MrFarbaek/Stensborg-A-S/Epson ET-M1120 modification files v1.1/3D print files/Barrel/ET-M1120 parts/EndLeft.SLDPRT

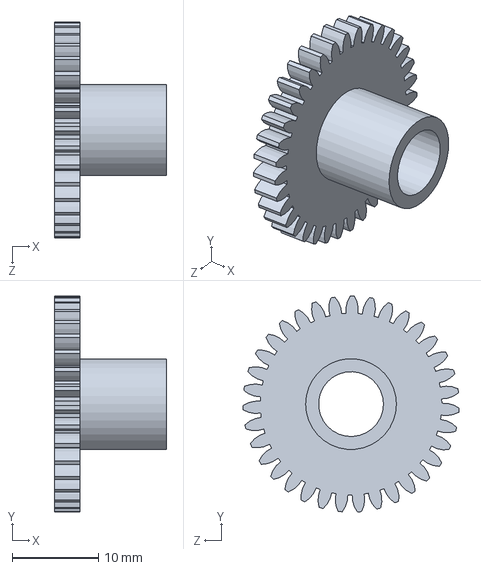
[picture p1: CAD file, 2022-03-11]
Epson ET-M1120 modification files v1.1/3D print files/Barrel/ET-M1120 parts/EndLeft.SLDPRT
13.0 x 25.0 x 25.0 mm
