MrFarbaek/Stensborg-A-S/Epson ET-M1120 modification files v1.1/3D print files/Barrel/SLDPRT files/BracketLeftBarrel.SLDPRT

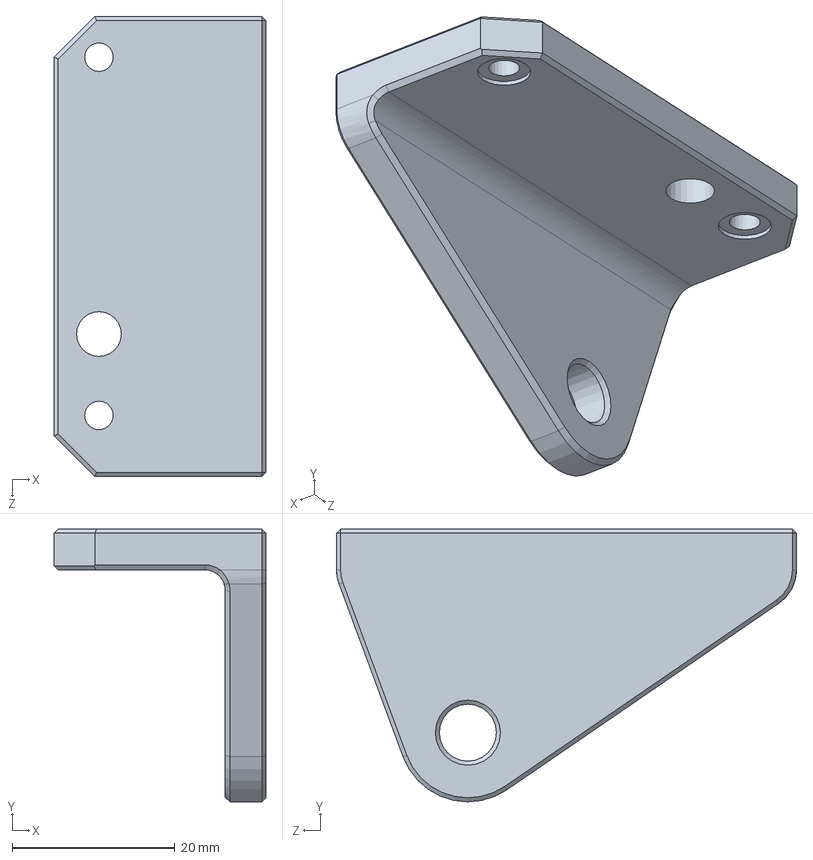
[picture p2: CAD file, 2022-03-11]
Epson ET-M1120 modification files v1.1/3D print files/Barrel/SLDPRT files/BracketLeftBarrel.SLDPRT
26.0 x 33.5 x 56.5 mm
