MrFarbaek/Stensborg-A-S/Epson ET-M1120 modification files v1.1/3D print files/Barrel/STEP files/Barrel.STEP

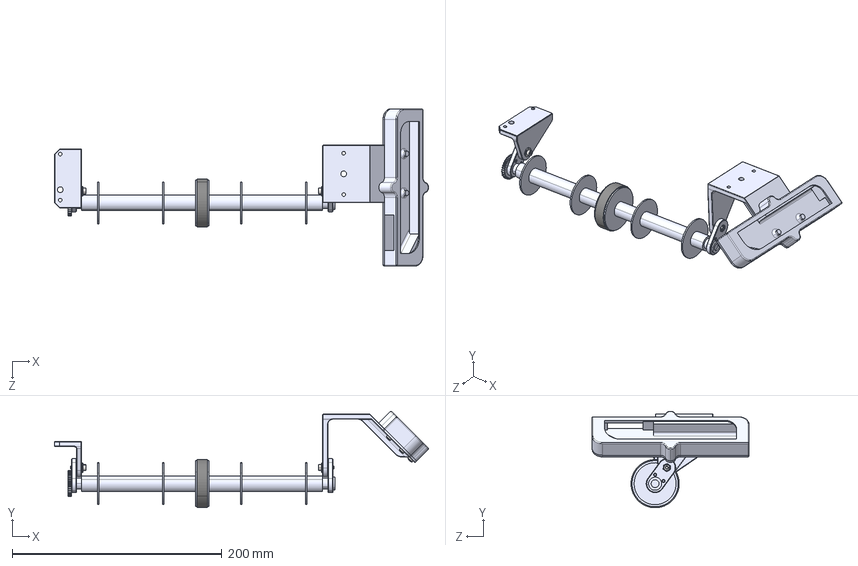
[picture p3: CAD file, 2022-03-11]
Epson ET-M1120 modification files v1.1/3D print files/Barrel/STEP files/Barrel.STEP
357.0 x 92.1 x 150.0 mm
BracketLeftBarrel
Top_v1.1
Bottom_v1.1
pan head cross recess screw_iso_ISO 7045 - M3 x 8 - Z - 8N x 5
Arm x 2
Barrel
BarrelSleeve
EndRight
EndLeft
hex thin nut chamfered gradeab_iso_ISO - 4035 - M3 - N x 2
plain washer 10669 type nl_iso_ISO 10669-3.55-N x 2
socket head cap screw_iso_ISO 4762 M3 x 12 - 12N x 2
