MrFarbaek/Stensborg-A-S/Epson ET-M1120 modification files v1.1/3D print files/Barrel/STL files/Bottom_v1.1.STL

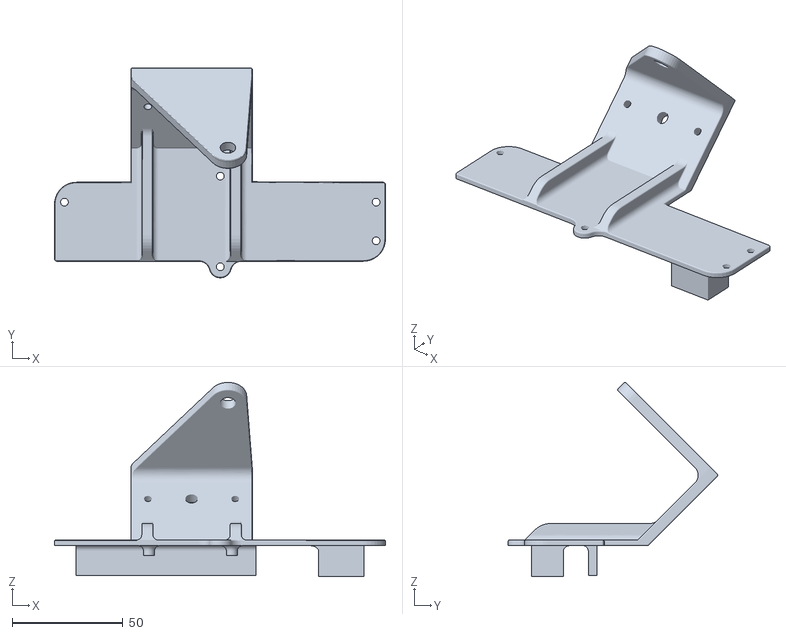
[picture p4: CAD file, 2022-03-11]
Epson ET-M1120 modification files v1.1/3D print files/Barrel/STL files/Bottom_v1.1.STL
149.8 x 94.9 x 87.8
