MrFarbaek/Stensborg-A-S/Epson ET-M1120 modification files v1.1/3D print files/Button mount/STEP files/ButtonMount_v1.1.STEP

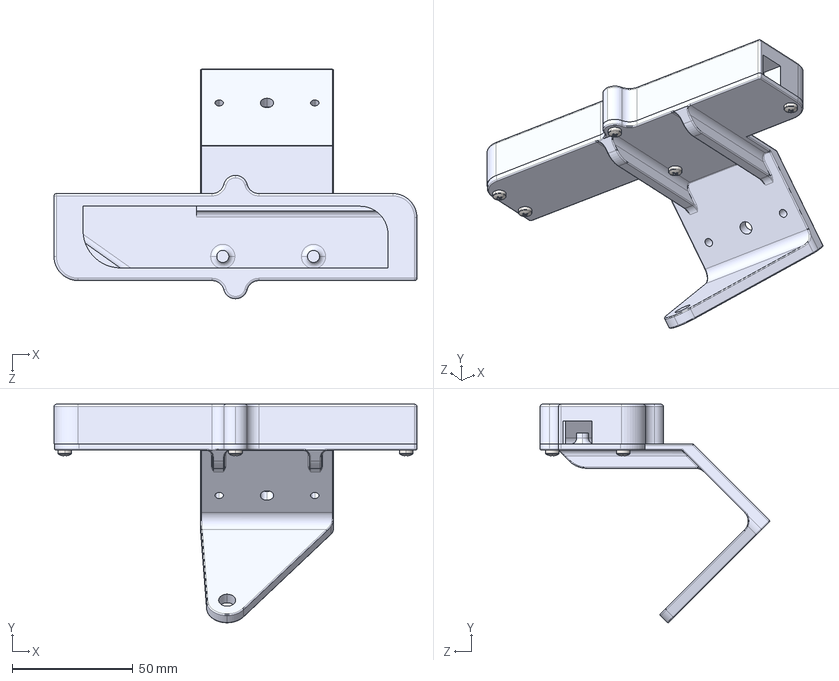
[picture p5: CAD file, 2022-03-11]
Epson ET-M1120 modification files v1.1/3D print files/Button mount/STEP files/ButtonMount_v1.1.STEP
150.0 x 90.3 x 94.9 mm
Top_v1.1
Bottom_v1.1
pan head cross recess screw_iso_ISO 7045 - M3 x 8 - Z - 8N x 5
