MrFarbaek/Stensborg-A-S/Epson ET-M1120 modification files v1.1/3D print files/Feeding mechanism/ET-M1120 parts/RubberSleeve.SLDPRT

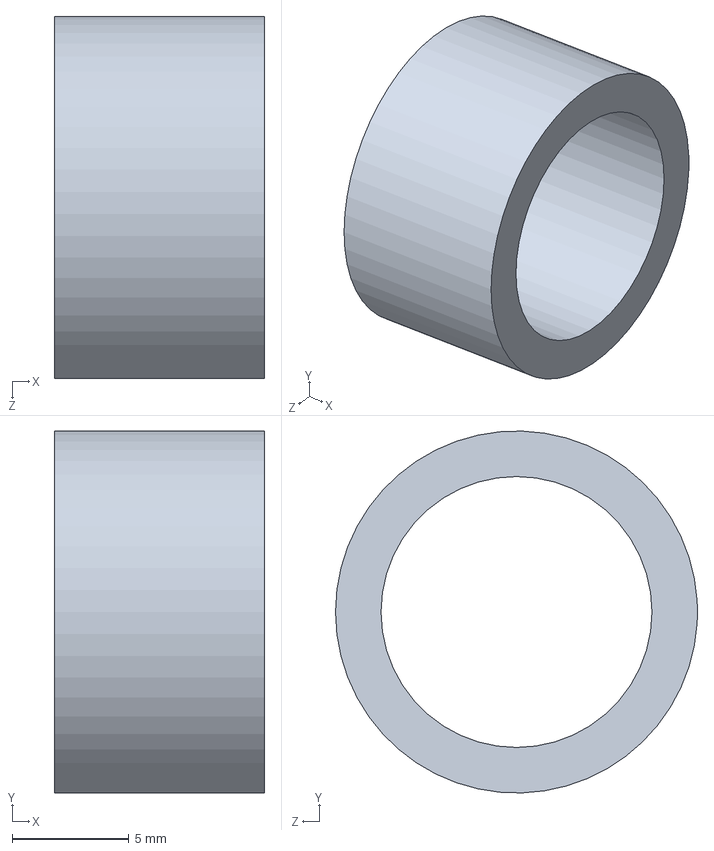
[picture p6: CAD file, 2022-03-11]
Epson ET-M1120 modification files v1.1/3D print files/Feeding mechanism/ET-M1120 parts/RubberSleeve.SLDPRT
9.00 x 15.5 x 15.5 mm
