MrFarbaek/Stensborg-A-S/Epson ET-M1120 modification files v1.1/3D print files/Feeding mechanism/Store bought parts/GearAxle.SLDPRT

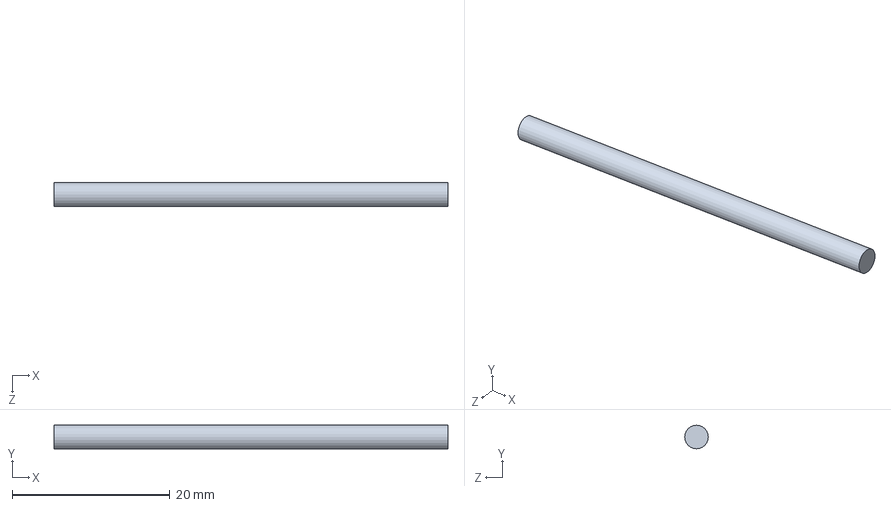
[picture p9: CAD file, 2022-03-11]
Epson ET-M1120 modification files v1.1/3D print files/Feeding mechanism/Store bought parts/GearAxle.SLDPRT
50.0 x 3.00 x 3.00 mm
