MrFarbaek/Stensborg-A-S/Epson ET-M1120 modification files v1.1/3D print files/Feeding tray/SupportLegFT.STEP

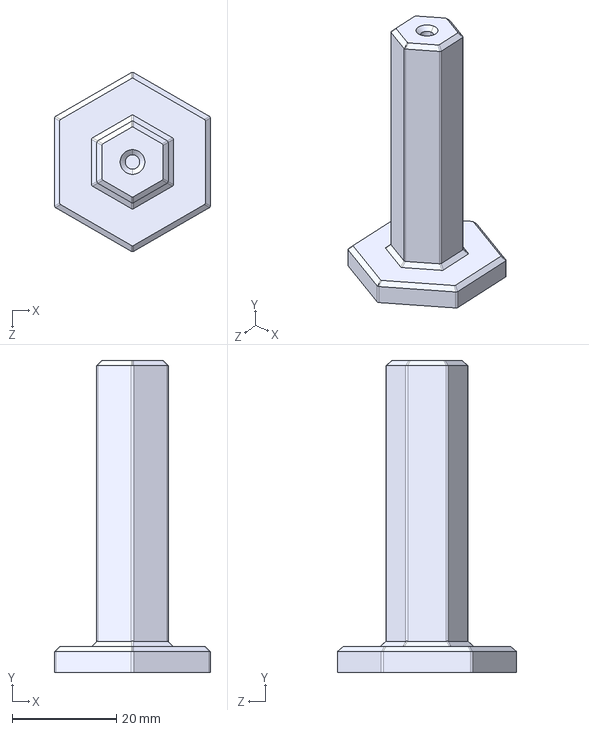
[picture p10: CAD file, 2022-03-11]
Epson ET-M1120 modification files v1.1/3D print files/Feeding tray/SupportLegFT.STEP
30.0 x 60.0 x 34.5 mm
