MrFarbaek/Stensborg-A-S/Epson ET-M1120 modification files v1.1/3D print files/Holding peg/HoldingPegL30V60.STEP

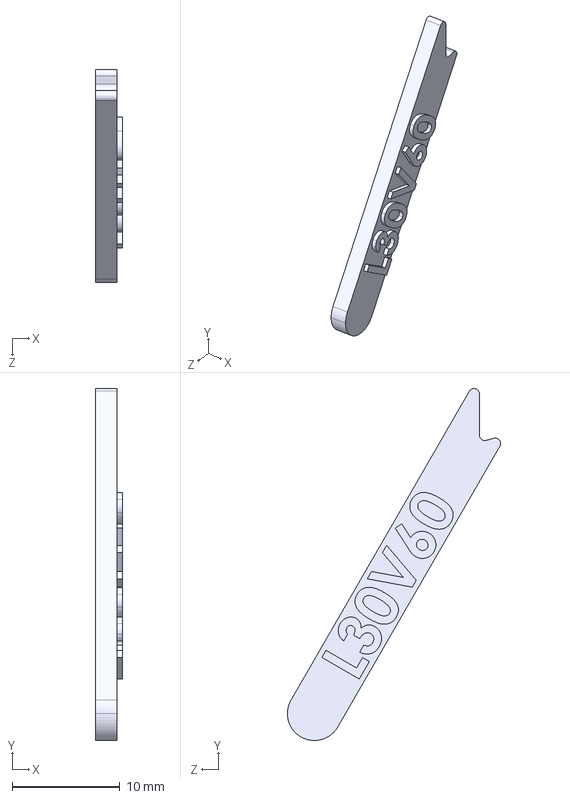
[picture p11: CAD file, 2022-03-11]
Epson ET-M1120 modification files v1.1/3D print files/Holding peg/HoldingPegL30V60.STEP
2.50 x 32.6 x 19.8 mm
