MrFarbaek/Stensborg-A-S/Epson ET-M1120 modification files v1.1/3D print files/Barrel/ET-M1120 parts/Barrel.SLDPRT

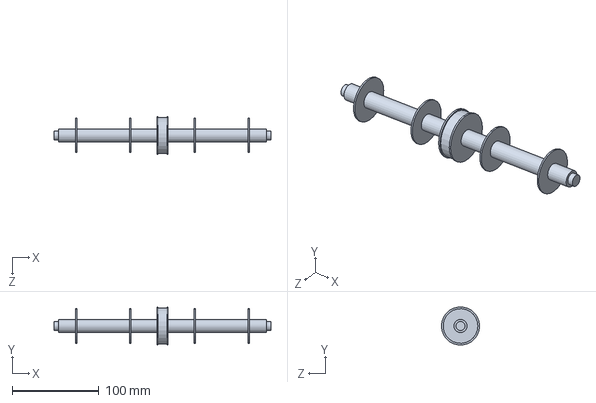
[picture p14: CAD file, 2022-03-11]
Epson ET-M1120 modification files v1.1/3D print files/Barrel/ET-M1120 parts/Barrel.SLDPRT
250.0 x 43.7 x 44.0 mm
