MrFarbaek/Stensborg-A-S/Epson ET-M1120 modification files v1.1/3D print files/Barrel/SLDPRT files/Arm.SLDPRT

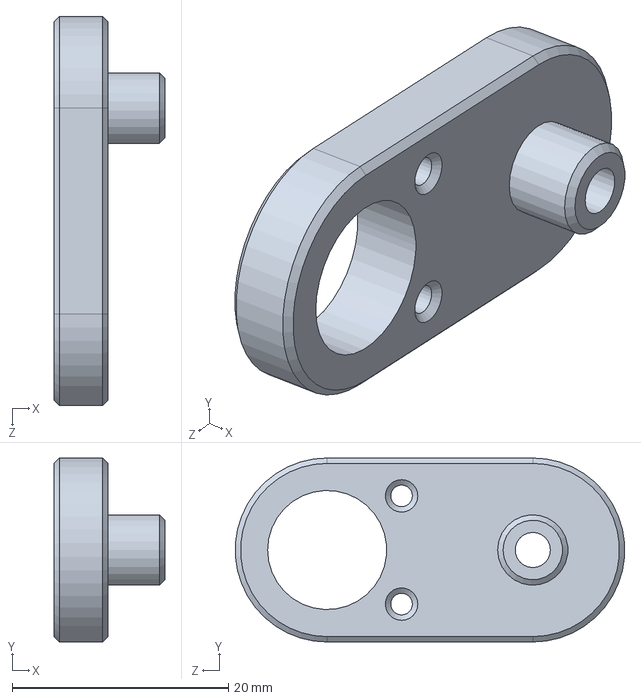
[picture p15: CAD file, 2022-03-11]
Epson ET-M1120 modification files v1.1/3D print files/Barrel/SLDPRT files/Arm.SLDPRT
10.2 x 17.0 x 36.0 mm
