MrFarbaek/Stensborg-A-S/Epson ET-M1120 modification files v1.1/3D print files/Barrel/STL files/Top_v1.1.STL

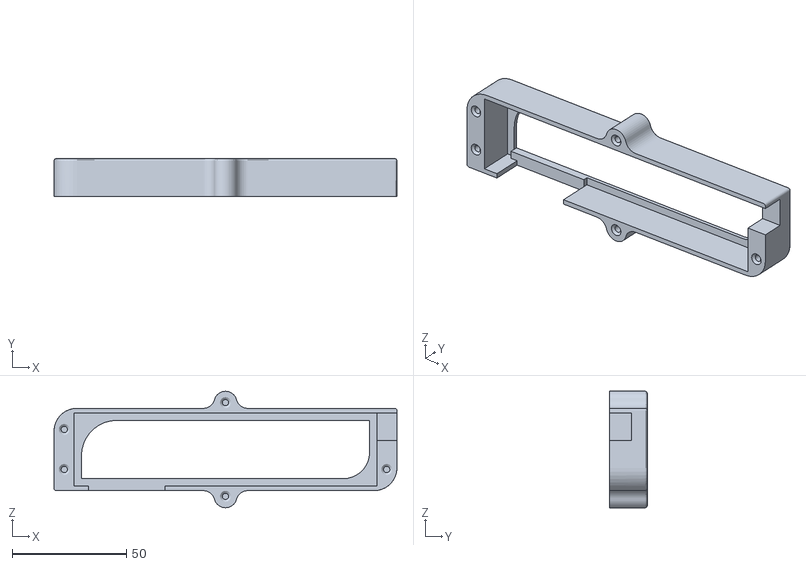
[picture p16: CAD file, 2022-03-11]
Epson ET-M1120 modification files v1.1/3D print files/Barrel/STL files/Top_v1.1.STL
150.0 x 16.5 x 51.0
