MrFarbaek/Stensborg-A-S/Epson ET-M1120 modification files v1.1/3D print files/Button mount/SLDPRT files/Top_v1.1.SLDPRT

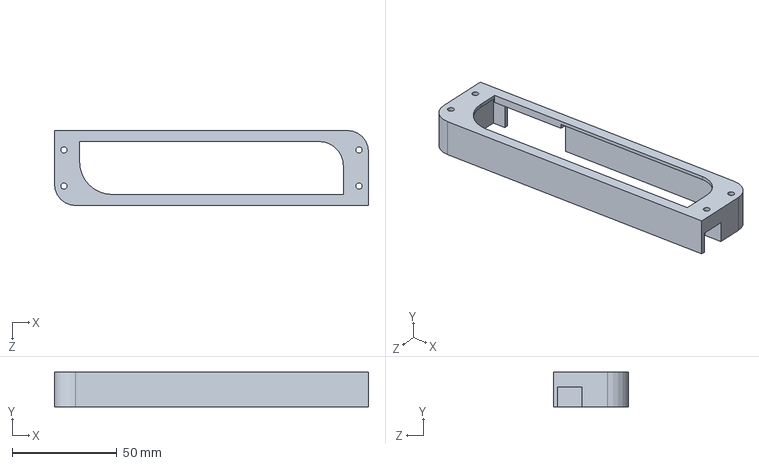
[picture p17: CAD file, 2022-03-11]
Epson ET-M1120 modification files v1.1/3D print files/Button mount/SLDPRT files/Top_v1.1.SLDPRT
149.8 x 16.5 x 35.8 mm
