MrFarbaek/Stensborg-A-S/Epson ET-M1120 modification files v1.1/3D print files/Feeding mechanism/SLDPRT files/ConnectorPlateRight_v1.1.SLDPRT

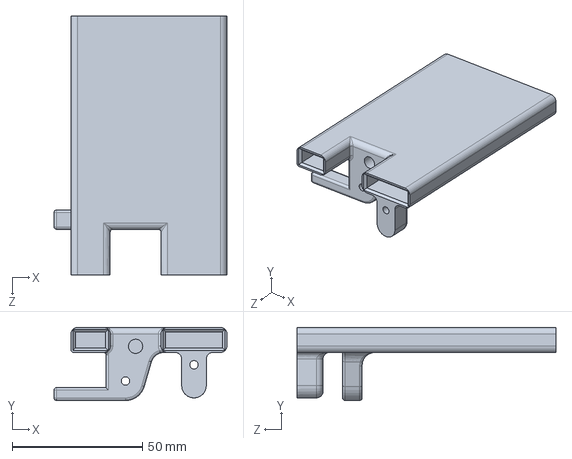
[picture p18: CAD file, 2022-03-11]
Epson ET-M1120 modification files v1.1/3D print files/Feeding mechanism/SLDPRT files/ConnectorPlateRight_v1.1.SLDPRT
66.5 x 28.1 x 99.5 mm
