MrFarbaek/Stensborg-A-S/Epson ET-M1120 modification files v1.1/3D print files/Landing platform/SLDPRT files/SupportLegsLP.SLDPRT

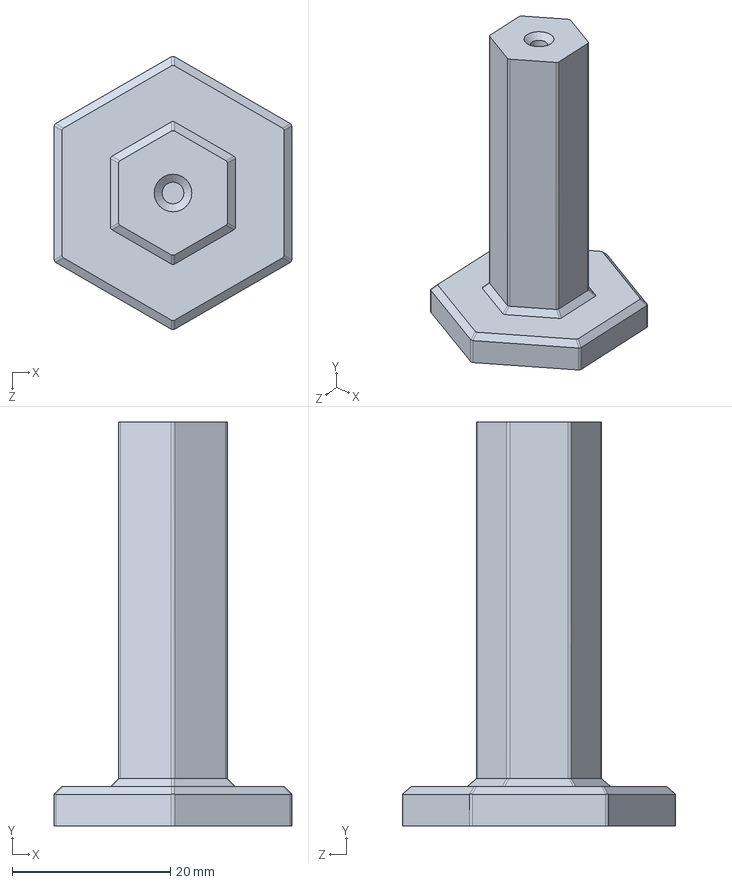
[picture p19: CAD file, 2022-03-11]
Epson ET-M1120 modification files v1.1/3D print files/Landing platform/SLDPRT files/SupportLegsLP.SLDPRT
30.0 x 51.0 x 34.5 mm
