MrFarbaek/Stensborg-A-S/Epson ET-M1120 modification files v1.1/3D print files/Barrel/ET-M1120 parts/EndRight.SLDPRT

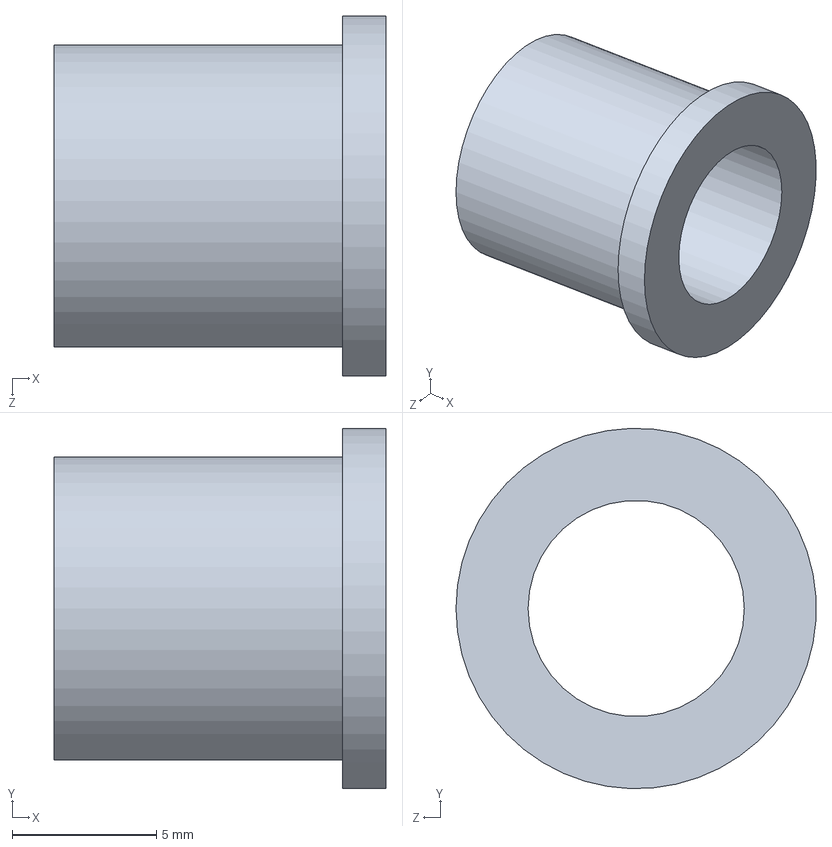
[picture p20: CAD file, 2022-03-11]
Epson ET-M1120 modification files v1.1/3D print files/Barrel/ET-M1120 parts/EndRight.SLDPRT
11.5 x 12.5 x 12.5 mm
