MrFarbaek/Stensborg-A-S/Epson ET-M1120 modification files v1.1/3D print files/Feeding mechanism/SLDPRT files/Gear_v1.1.SLDPRT

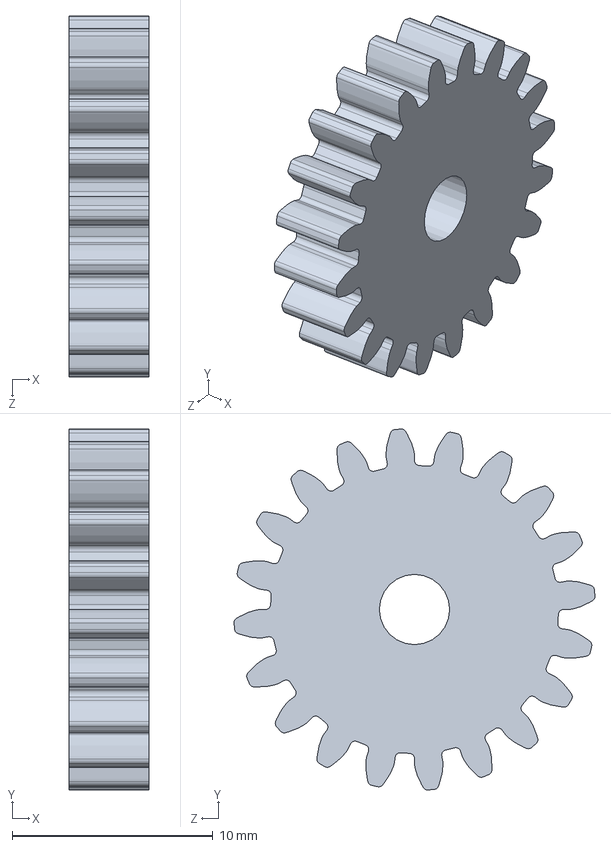
[picture p21: CAD file, 2022-03-11]
Epson ET-M1120 modification files v1.1/3D print files/Feeding mechanism/SLDPRT files/Gear_v1.1.SLDPRT
4.00 x 18.0 x 18.0 mm
