MrFarbaek/Stensborg-A-S/Epson ET-M1120 modification files v1.1/3D print files/Landing platform/SLDPRT files/Extension.SLDPRT

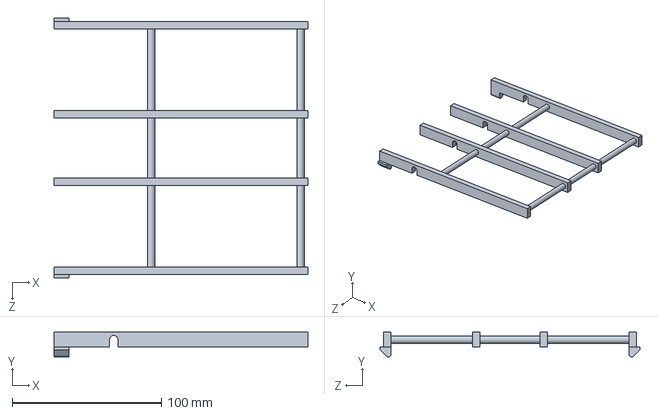
[picture p22: CAD file, 2022-03-11]
Epson ET-M1120 modification files v1.1/3D print files/Landing platform/SLDPRT files/Extension.SLDPRT
170.0 x 16.7 x 174.0 mm
