MrFarbaek/Stensborg-A-S/Epson ET-M1120 modification files v1.1/3D print files/Barrel/ET-M1120 parts/BarrelSleeve.SLDPRT

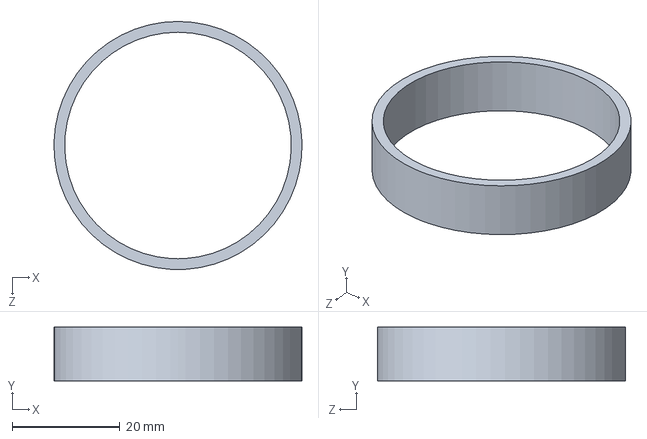
[picture p23: CAD file, 2022-03-11]
Epson ET-M1120 modification files v1.1/3D print files/Barrel/ET-M1120 parts/BarrelSleeve.SLDPRT
46.0 x 10.0 x 46.0 mm
