MrFarbaek/Stensborg-A-S/Epson ET-M1120 modification files v1.1/3D print files/Feeding mechanism/SLDPRT files/BracketRightFM_v1.1.SLDPRT

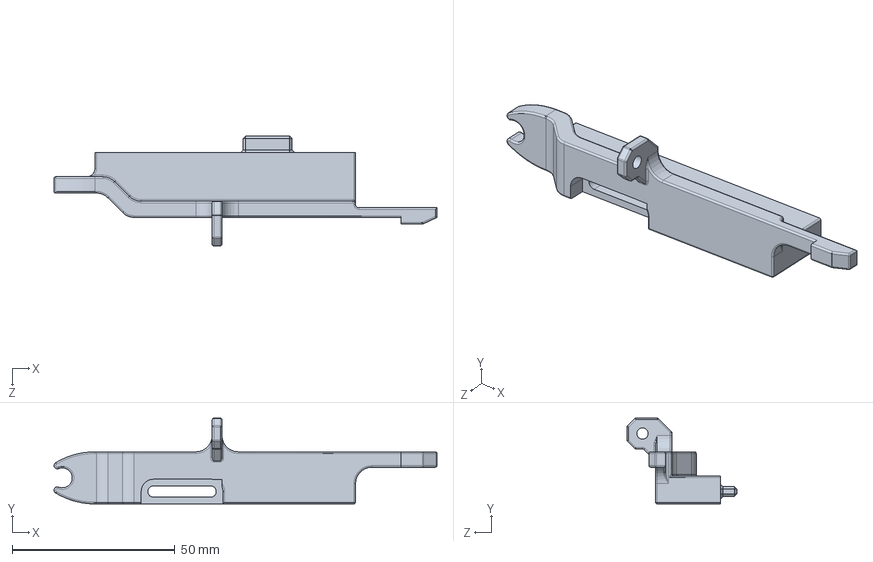
[picture p24: CAD file, 2022-03-11]
Epson ET-M1120 modification files v1.1/3D print files/Feeding mechanism/SLDPRT files/BracketRightFM_v1.1.SLDPRT
117.6 x 26.4 x 33.8 mm
