MrFarbaek/Stensborg-A-S/Epson ET-M1120 modification files v1.1/3D print files/Feeding mechanism/SLDPRT files/BracketLeftFM_v1.1.SLDPRT

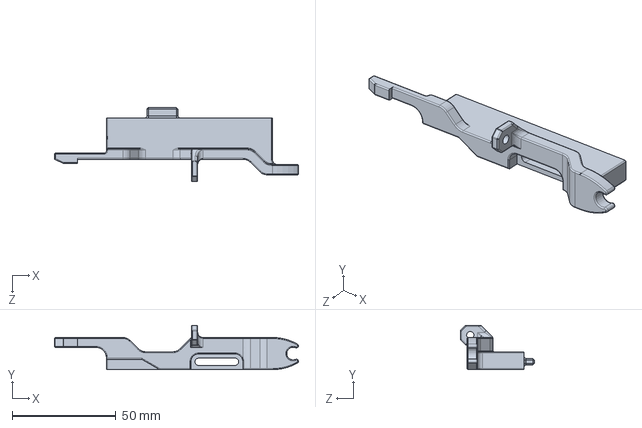
[picture p25: CAD file, 2022-03-11]
Epson ET-M1120 modification files v1.1/3D print files/Feeding mechanism/SLDPRT files/BracketLeftFM_v1.1.SLDPRT
117.6 x 21.4 x 35.8 mm
