MrFarbaek/Stensborg-A-S/Epson ET-M1120 modification files v1.1/3D print files/Feeding mechanism/SLDPRT files/GearWithSleeves_v1.1.SLDPRT

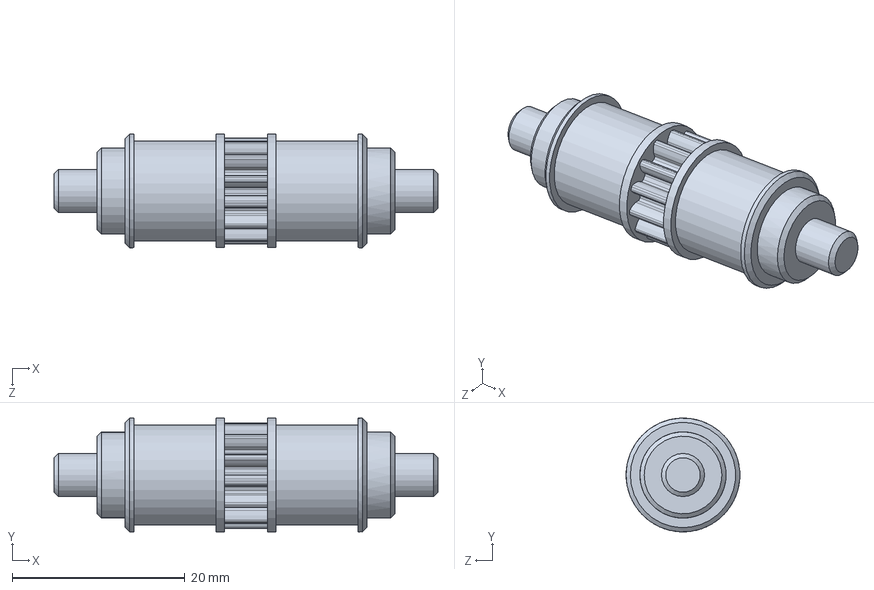
[picture p26: CAD file, 2022-03-11]
Epson ET-M1120 modification files v1.1/3D print files/Feeding mechanism/SLDPRT files/GearWithSleeves_v1.1.SLDPRT
44.5 x 13.2 x 13.2 mm
