MrFarbaek/Stensborg-A-S/Epson ET-M1120 modification files v1.1/3D print files/Feeding mechanism/SLDPRT files/Spacer_v1.1.SLDPRT

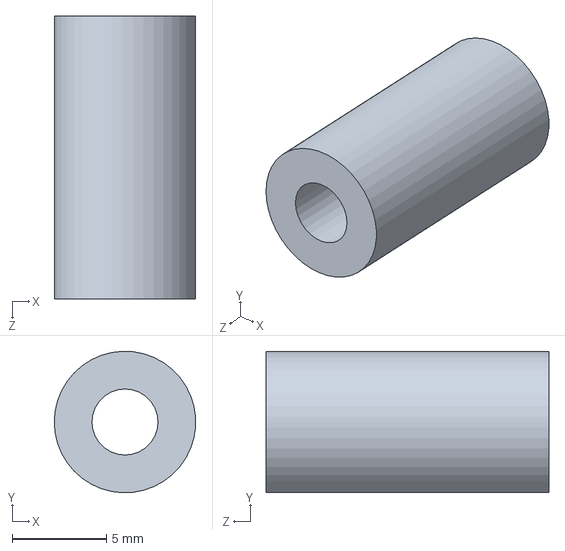
[picture p27: CAD file, 2022-03-11]
Epson ET-M1120 modification files v1.1/3D print files/Feeding mechanism/SLDPRT files/Spacer_v1.1.SLDPRT
7.50 x 7.49 x 15.0 mm
