MrFarbaek/Stensborg-A-S/(list of files, cad)

Other CAD files:
Epson ET-M1120 modification files v1.1/3D print files/Button mount/SLDPRT files/Bottom_v1.1.SLDPRT
Epson ET-M1120 modification files v1.1/3D print files/Barrel/Barrel.SLDASM
Epson ET-M1120 modification files v1.1/3D print files/Barrel/STL files/Arm.STL
Epson ET-M1120 modification files v1.1/3D print files/Barrel/STL files/BracketLeftBarrel.STL
Epson ET-M1120 modification files v1.1/3D print files/Button mount/ButtonMount_v1.1.SLDASM
Epson ET-M1120 modification files v1.1/3D print files/Feeding mechanism/FeedingMechanism_v1.1.SLDASM
Epson ET-M1120 modification files v1.1/3D print files/Feeding mechanism/STL files/BracketLeftFM_v1.1.STL
Epson ET-M1120 modification files v1.1/3D print files/Feeding mechanism/STL files/BracketRightFM_v1.1.STL
Epson ET-M1120 modification files v1.1/3D print files/Feeding mechanism/STL files/ConnectorPlateLeft_v1.1.STL
Epson ET-M1120 modification files v1.1/3D print files/Feeding mechanism/STL files/ConnectorPlateRight_v1.1.STL
Epson ET-M1120 modification files v1.1/3D print files/Feeding mechanism/STL files/GearWithSleeves_v1.1.STL
Epson ET-M1120 modification files v1.1/3D print files/Feeding mechanism/STL files/Gear_v1.1.STL
Epson ET-M1120 modification files v1.1/3D print files/Feeding mechanism/STL files/Spacer_v1.1.STL
Epson ET-M1120 modification files v1.1/3D print files/Feeding tray/SupportLegFT.SLDPRT
Epson ET-M1120 modification files v1.1/3D print files/Feeding tray/SupportLegFT.STL
Epson ET-M1120 modification files v1.1/3D print files/Holding peg/HoldingPegL30V60.SLDPRT
Epson ET-M1120 modification files v1.1/3D print files/Holding peg/HoldingPegL30V60.STL
Epson ET-M1120 modification files v1.1/3D print files/Landing platform/LandingPlatform.SLDASM
Epson ET-M1120 modification files v1.1/3D print files/Landing platform/STL files/Extension.STL
Epson ET-M1120 modification files v1.1/3D print files/Landing platform/STL files/Platform.STL
Epson ET-M1120 modification files v1.1/3D print files/Landing platform/STL files/SupportLegsLP.STL
