MrFarbaek/Stensborg-A-S/Epson ET-M1120 modification files v1.1/3D print files/Feeding mechanism/Assembly drawings/Step1.PNG

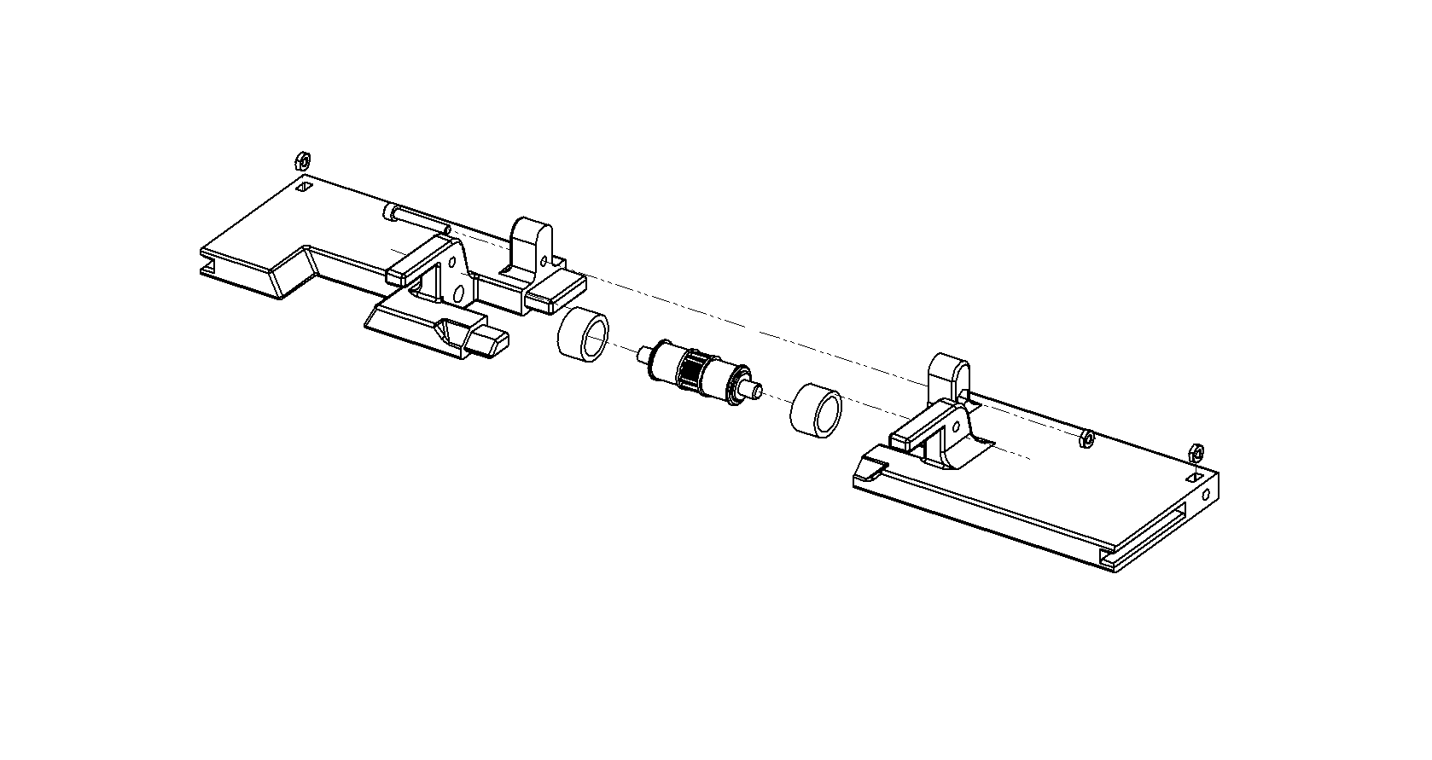
Epson ET-M1120 modification files v1.1/3D print files/Feeding mechanism/Assembly drawings/Step1.PNG
